ibib-us/make-things-move/README.md

# make-things-move
Create your own remote control robot from the ground up
