ibib-us/make-things-move/Hardware/README.md

# Hardware

This folder contains the latest schematic and layout of the featherwing for your robot.
