ibib-us/make-things-move/Hardware/Schematic v4.pdf

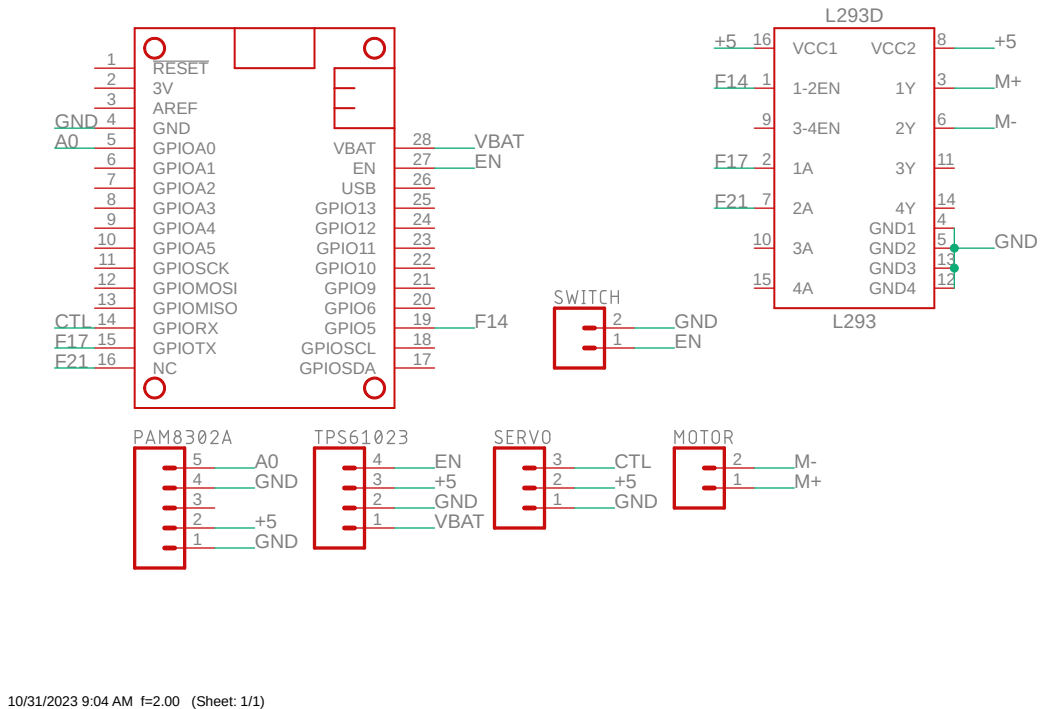
[picture p1: page 1]
10/31/2023 9:04 AM f=2.00 (Sheet: 1/1); GND1; GND2; VCC2; 8 VCC1 16; GND3; GND4; RESET 1 3V 2 AREF 3 GND 4 GPIOA0 5 GPIOA1 6 GPIOA2 7 GPIOA3 8 GPIOA4 9 GPIOA5 10 GPIOSCK 11 GPIOMOSI 12 GPIOMISO 13 GPIORX 14 GPIOTX 15; GPIOSDA; 17 GPIOSCL; 18 GPIO5; GPIO9; GPIO6; GPIO10; 22 GPIO11; 23 GPIO12; 24 GPIO13; USB; VBAT; GND; CTL
