ibib-us/make-things-move/Hardware/board-layout.pdf

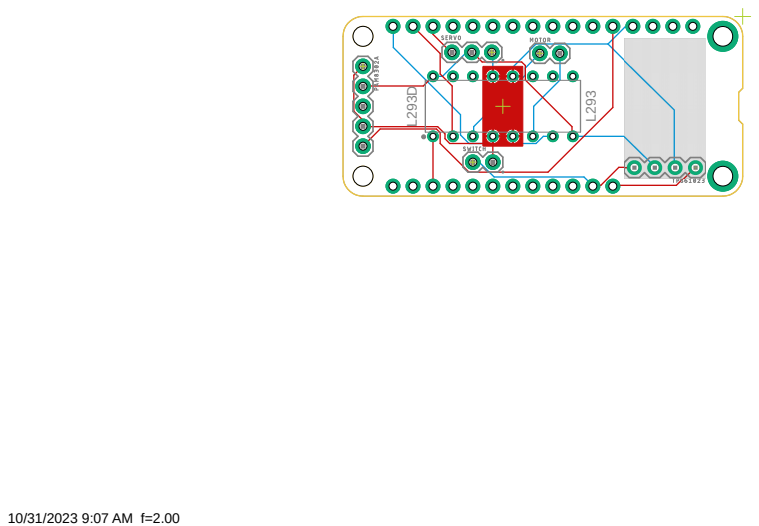
[picture p2: page 1]
