ibib-us/make-things-move/Hardware/PCB v7.brd

## EAGLE design Hardware/PCB v7.brd (2023-10-31)

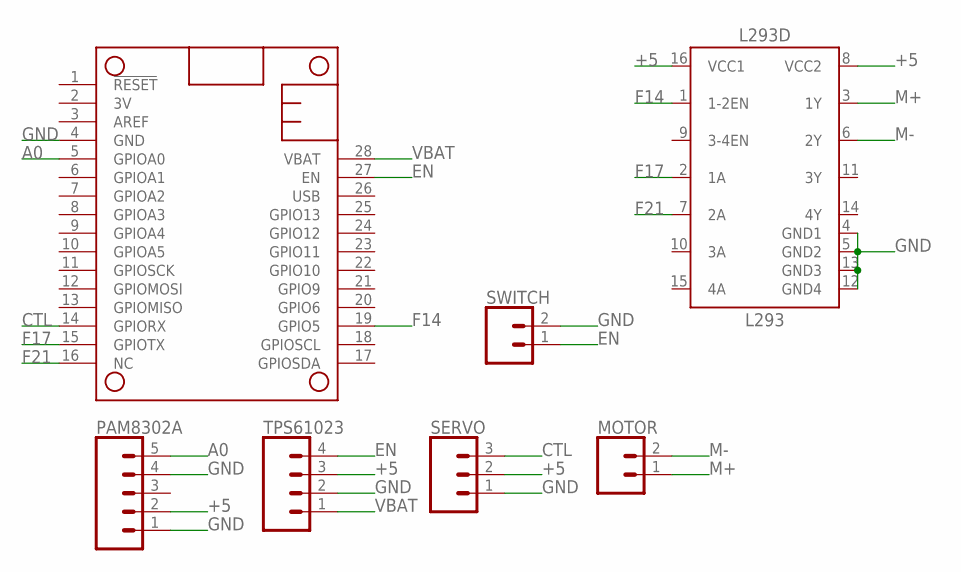
[picture p3: schematic Schematic_v4.sch]

Parts:
L293D: L293; DIP762W53P254L1969H508Q16B
MOTOR: CONN_02; 1X02
MS1: FEATHERWING_NODIM; FEATHERWING_DIM
PAM8302A: CONN_05; 1X05
SERVO: CONN_03; 1X03
SWITCH: CONN_02; 1X02
TPS61023: CONN_04; 1X04

Connections:
+5: L293D.8 (VCC2), L293D.16 (VCC1), PAM8302A.2, SERVO.2, TPS61023.3
A0: MS1.5 (GPIOA0), PAM8302A.5
CTL: MS1.14 (GPIORX), SERVO.3
EN: MS1.27 (EN), SWITCH.1, TPS61023.4
F14: L293D.1 (1-2EN), MS1.19 (GPIO5)
F17: L293D.2 (1A), MS1.15 (GPIOTX)
F21: L293D.7 (2A), MS1.16 (NC)
GND: L293D.4 (GND1), L293D.5 (GND2), L293D.12 (GND4), L293D.13 (GND3), MS1.4 (GND), PAM8302A.1, PAM8302A.4, SERVO.1, SWITCH.2, TPS61023.2
M+: L293D.3 (1Y), MOTOR.1
M-: L293D.6 (2Y), MOTOR.2
VBAT: MS1.28 (VBAT), TPS61023.1

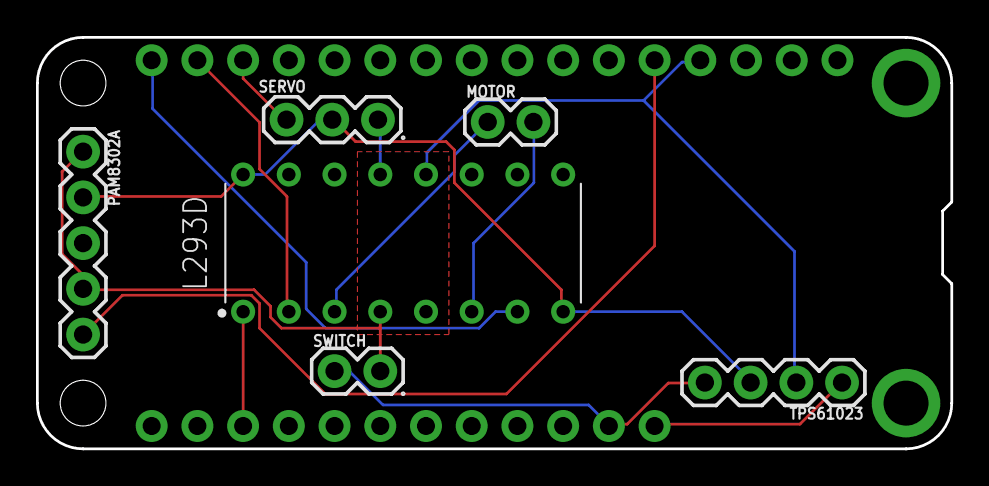
[picture p4: board PCB v7.brd from above]

Board: 2 copper layers, 50.8 x 22.9 mm, 7 parts (0 on the bottom side), 11 nets.
