ibib-us/make-things-move/Instructions/media/mounted_motors.jpg

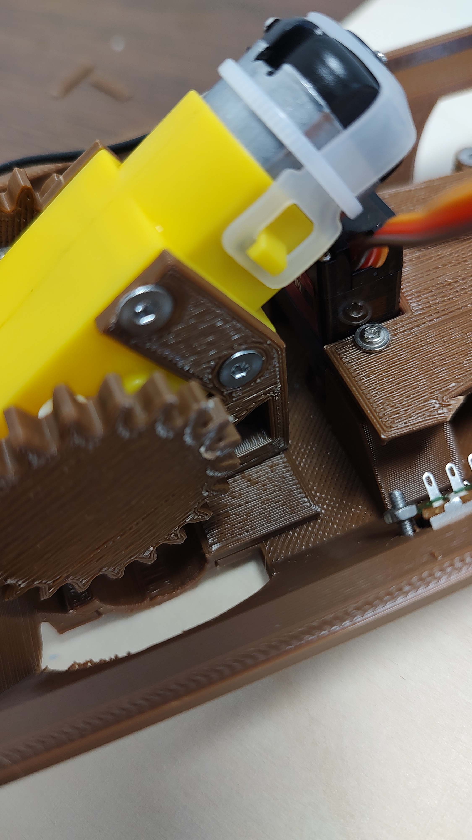
Instructions/media/mounted_motors.jpg
