ibib-us/make-things-move/MakeThingsMove/Settings.h

#pragma once

 // Robot name
#define ROBOT_NAME "My Robot"

// Uncomment the following line to enable debugging mode
// #define DEBUG_MODE

// Uncomment the following line to enable audio
// #define AUDIO_ENABLED

// Robot settings which may vary between robot builds

// The duty cycle at which the robot's servo motor points the robot all the way to the left
#define MIN_SERVO_DUTY 1800
// The duty cycle at which the robot's servo motor points the robot all the way to the right
#define MAX_SERVO_DUTY 7800
