ibib-us/make-things-move/(commit log)

2023-10-25 Fix audio flag name
    [MakeThingsMove.ino]
2023-10-25 Support for per-button custom callbacks
2023-10-29 Improvements and bug fixes from workshop
    [Robot.cpp, Robot.h]
2023-10-31 Added hardware docs
    [PCB v7.brd, Schematic_v4.sch]
2023-11-01 Move servo duty settings to settings file
